Darielsc28/unitypub/docs/oreillette_v1_pcb_cuivre_dessous.png

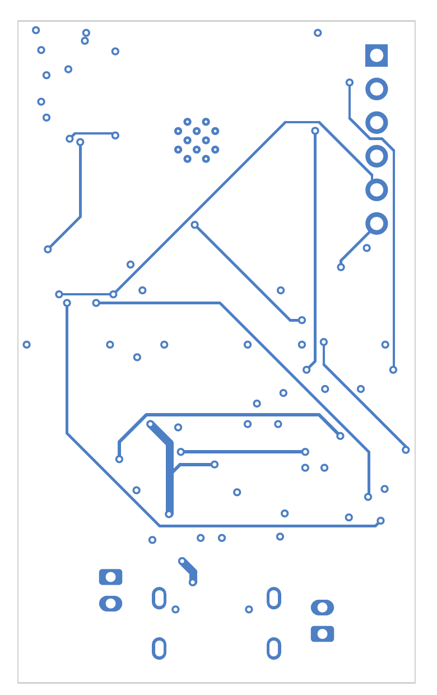
docs/oreillette_v1_pcb_cuivre_dessous.png
