Darielsc28/unitypub/docs/oreillette_v1_pcb_cuivre_dessus.png

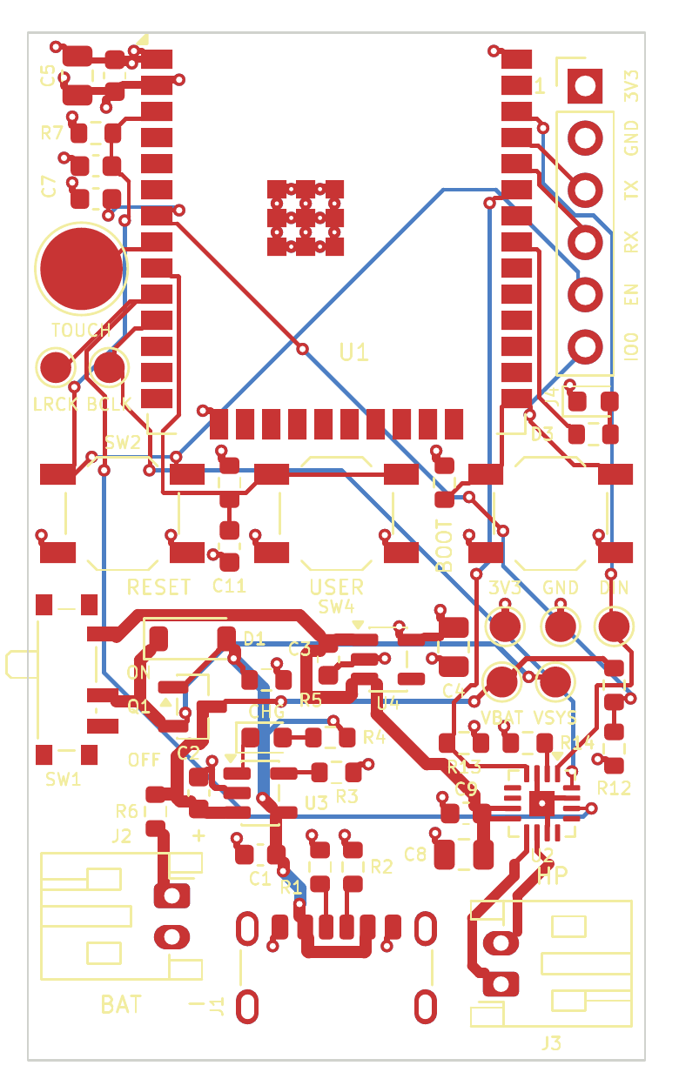
docs/oreillette_v1_pcb_cuivre_dessus.png
