Darielsc28/unitypub/docs/oreillette_v1_pcb_rendu_dessus.png

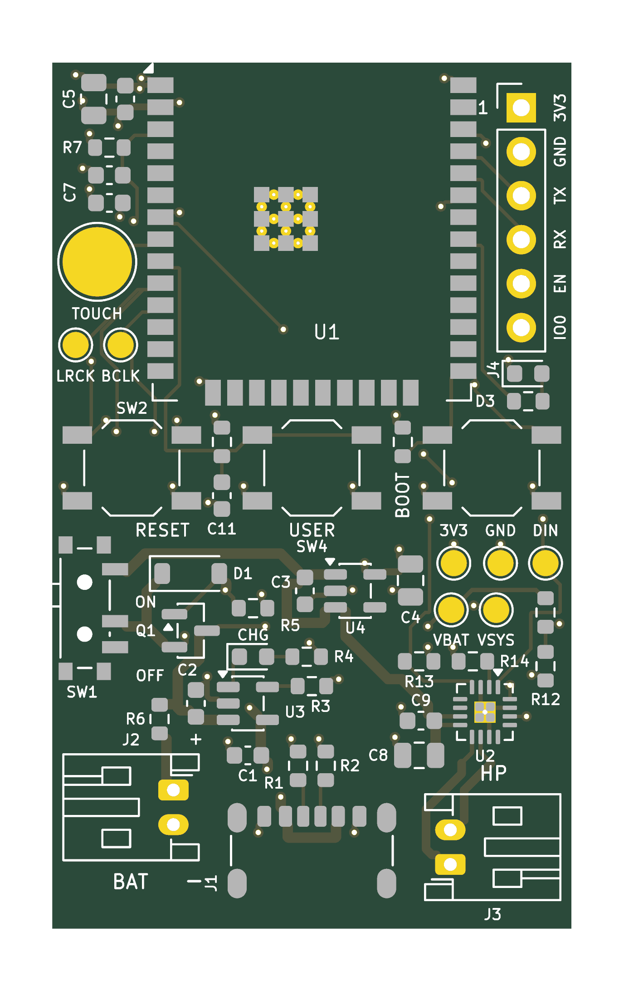
docs/oreillette_v1_pcb_rendu_dessus.png
