Darielsc28/unitypub/docs/oreillette_v1_pcb_couches.pdf

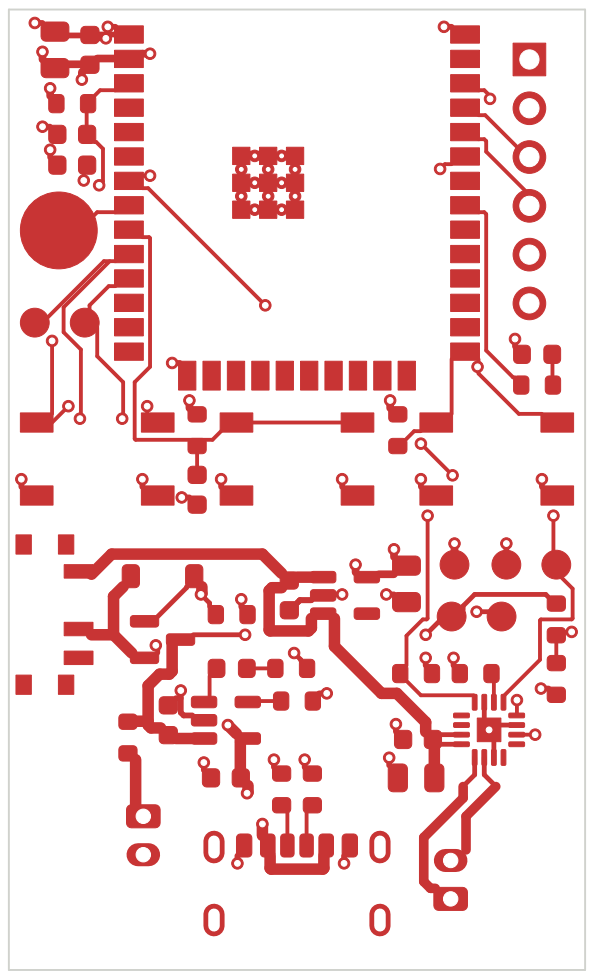
[picture p5: page 1]

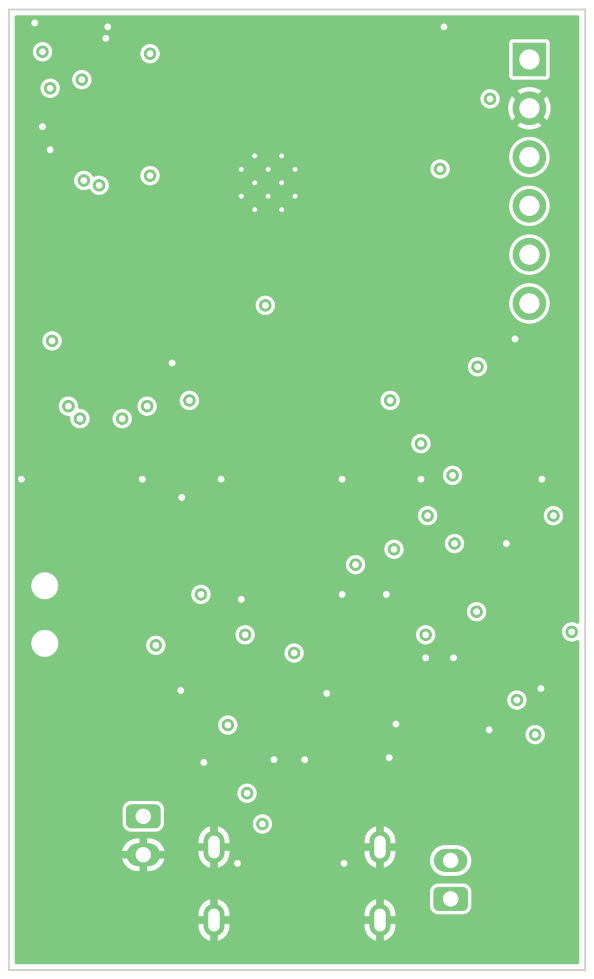
[picture p6: page 2]

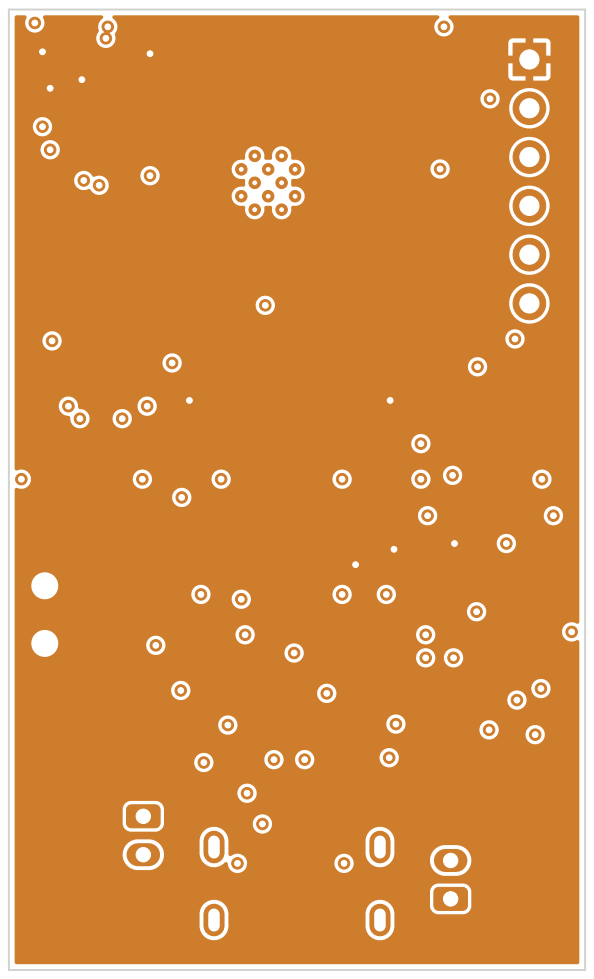
[picture p7: page 3]

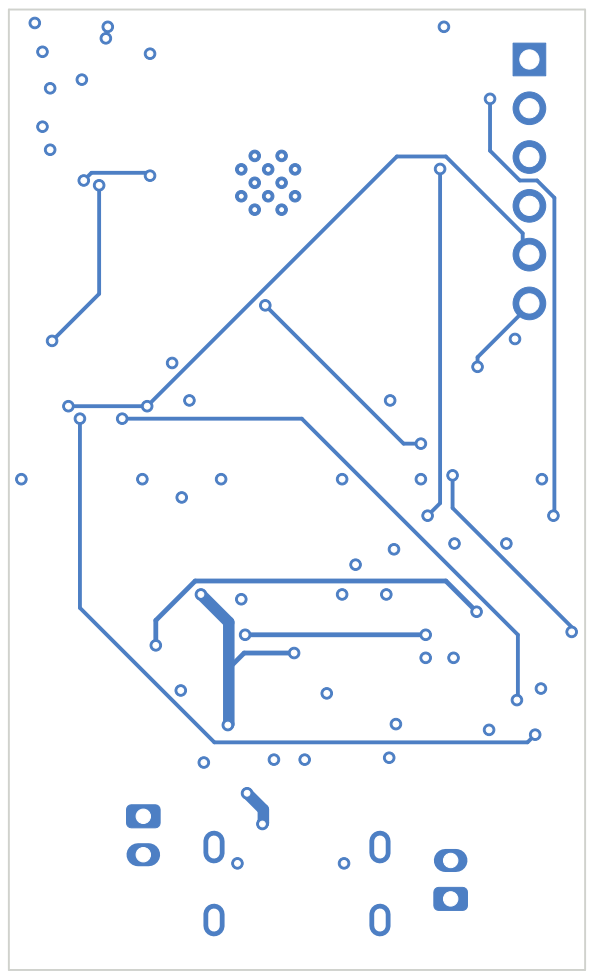
[picture p8: page 4]

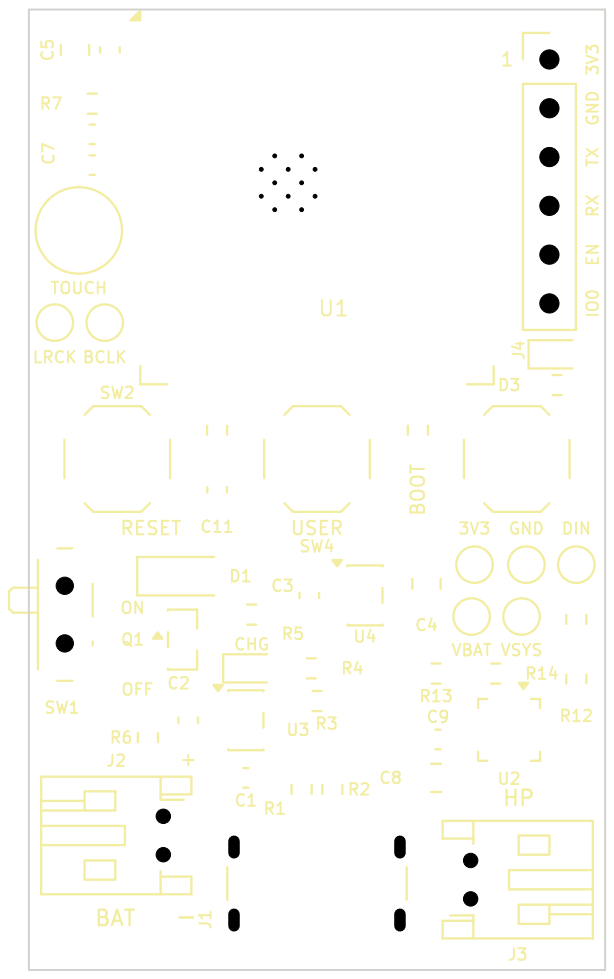
[picture p9: page 5]

3V3 VSYS GND DIN ³V³ GND TX RX EN IO⁰ RESET

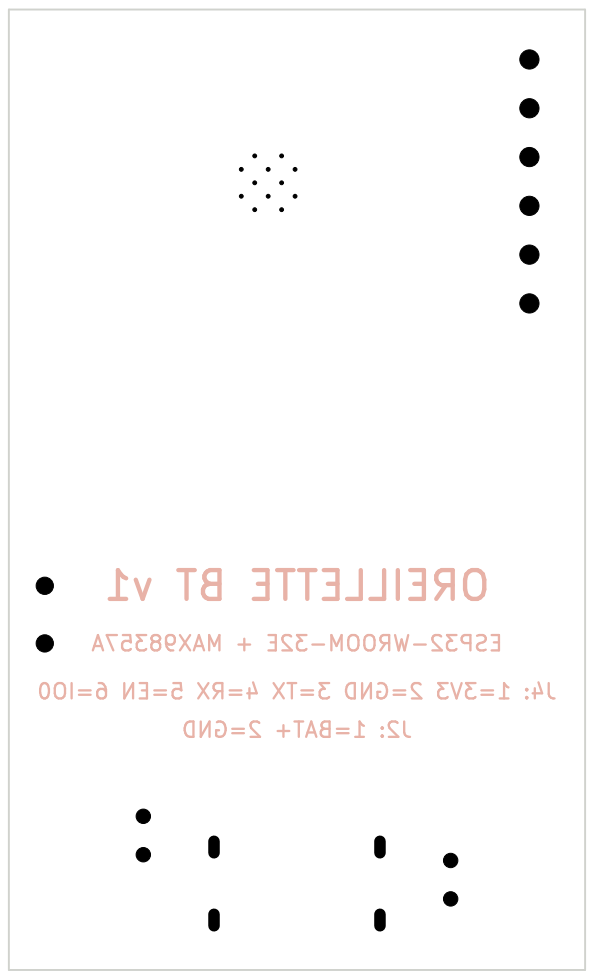
[picture p10: page 6]
MAX98357A + ESP32-WROOM-32E

6=IO0 5=EN 4=RX 3=TX 2=GND 1=3V3 J4: 2=GND 1=BAT+ J2: v1 BT OREILLETTE

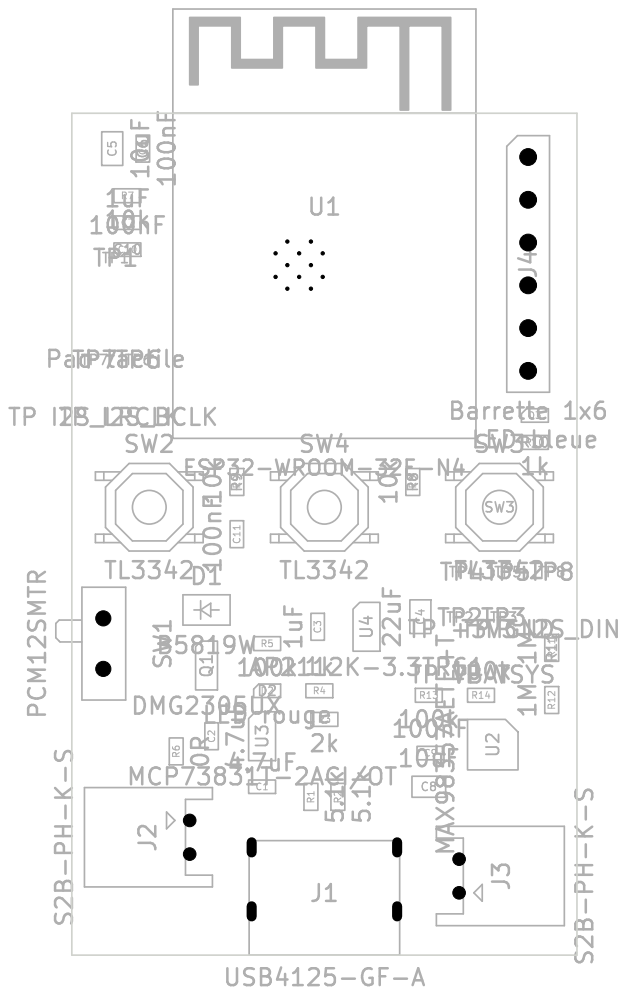
[picture p11: page 7]
