Darielsc28/unitypub/docs/oreillette_v1_schema.pdf

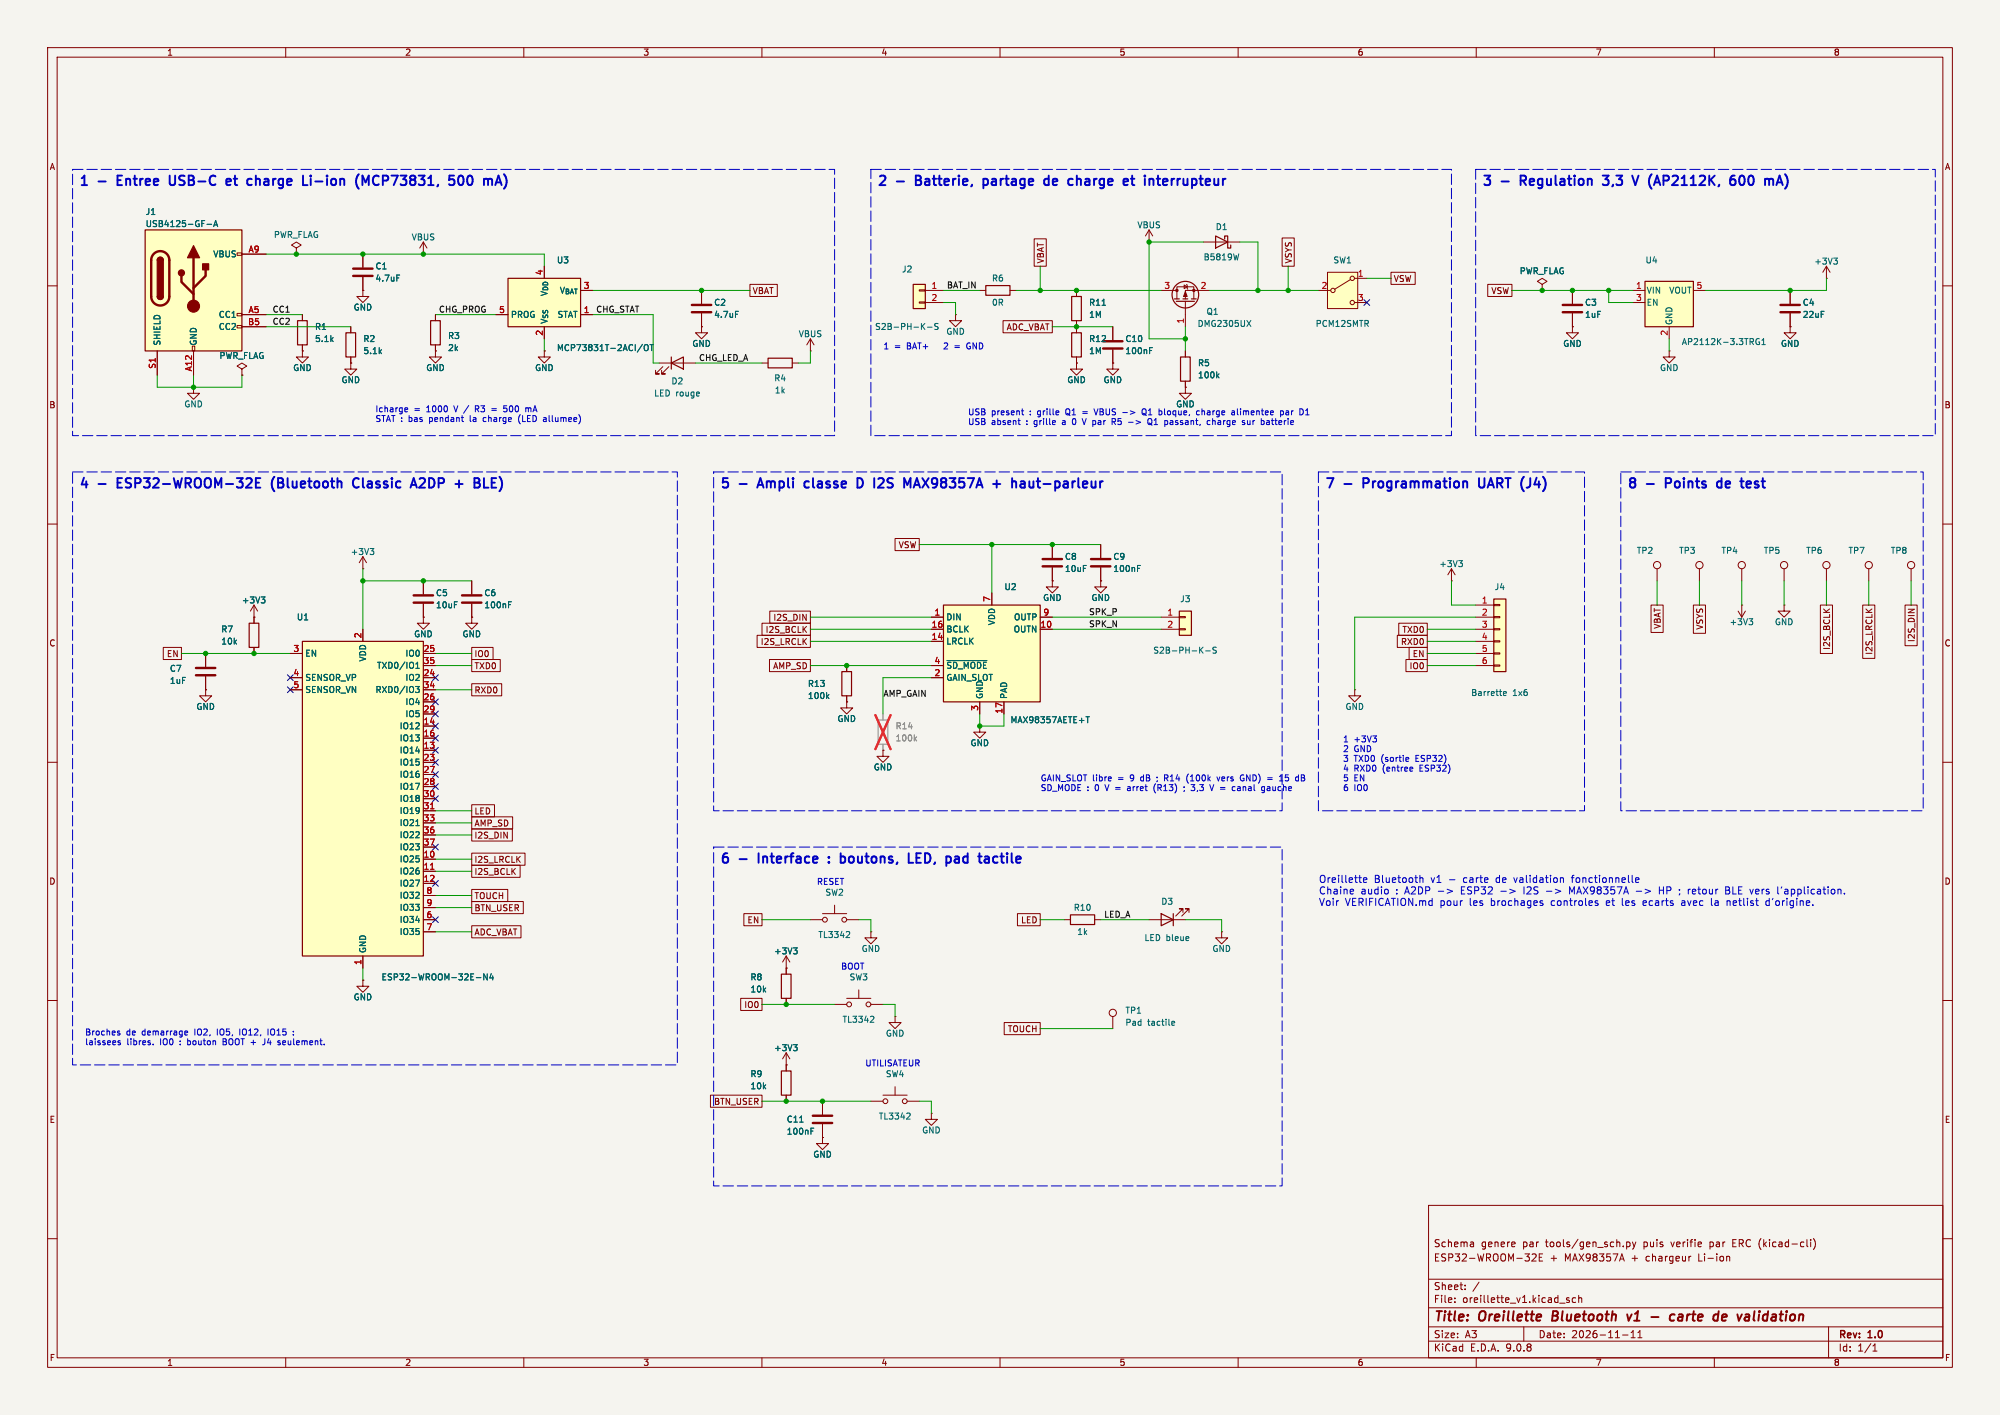
[picture p12: page 1]

SPK_P 2 - Batterie, partage de charge et interrupteur

Icharge = 1000 V / R3 = 500 mA
STAT : bas pendant la charge (LED allumee)

5 - Ampli classe D I2S MAX98357A + haut-parleur BOOT 6 - Interface : boutons, LED, pad tactile

Id: 1/1 Title: Oreillette Bluetooth v1 - carte de validation
