Darielsc28/unitypub/oreillette_v1.kicad_pcb

## KiCad design oreillette_v1.kicad_pcb (2026-11-11)

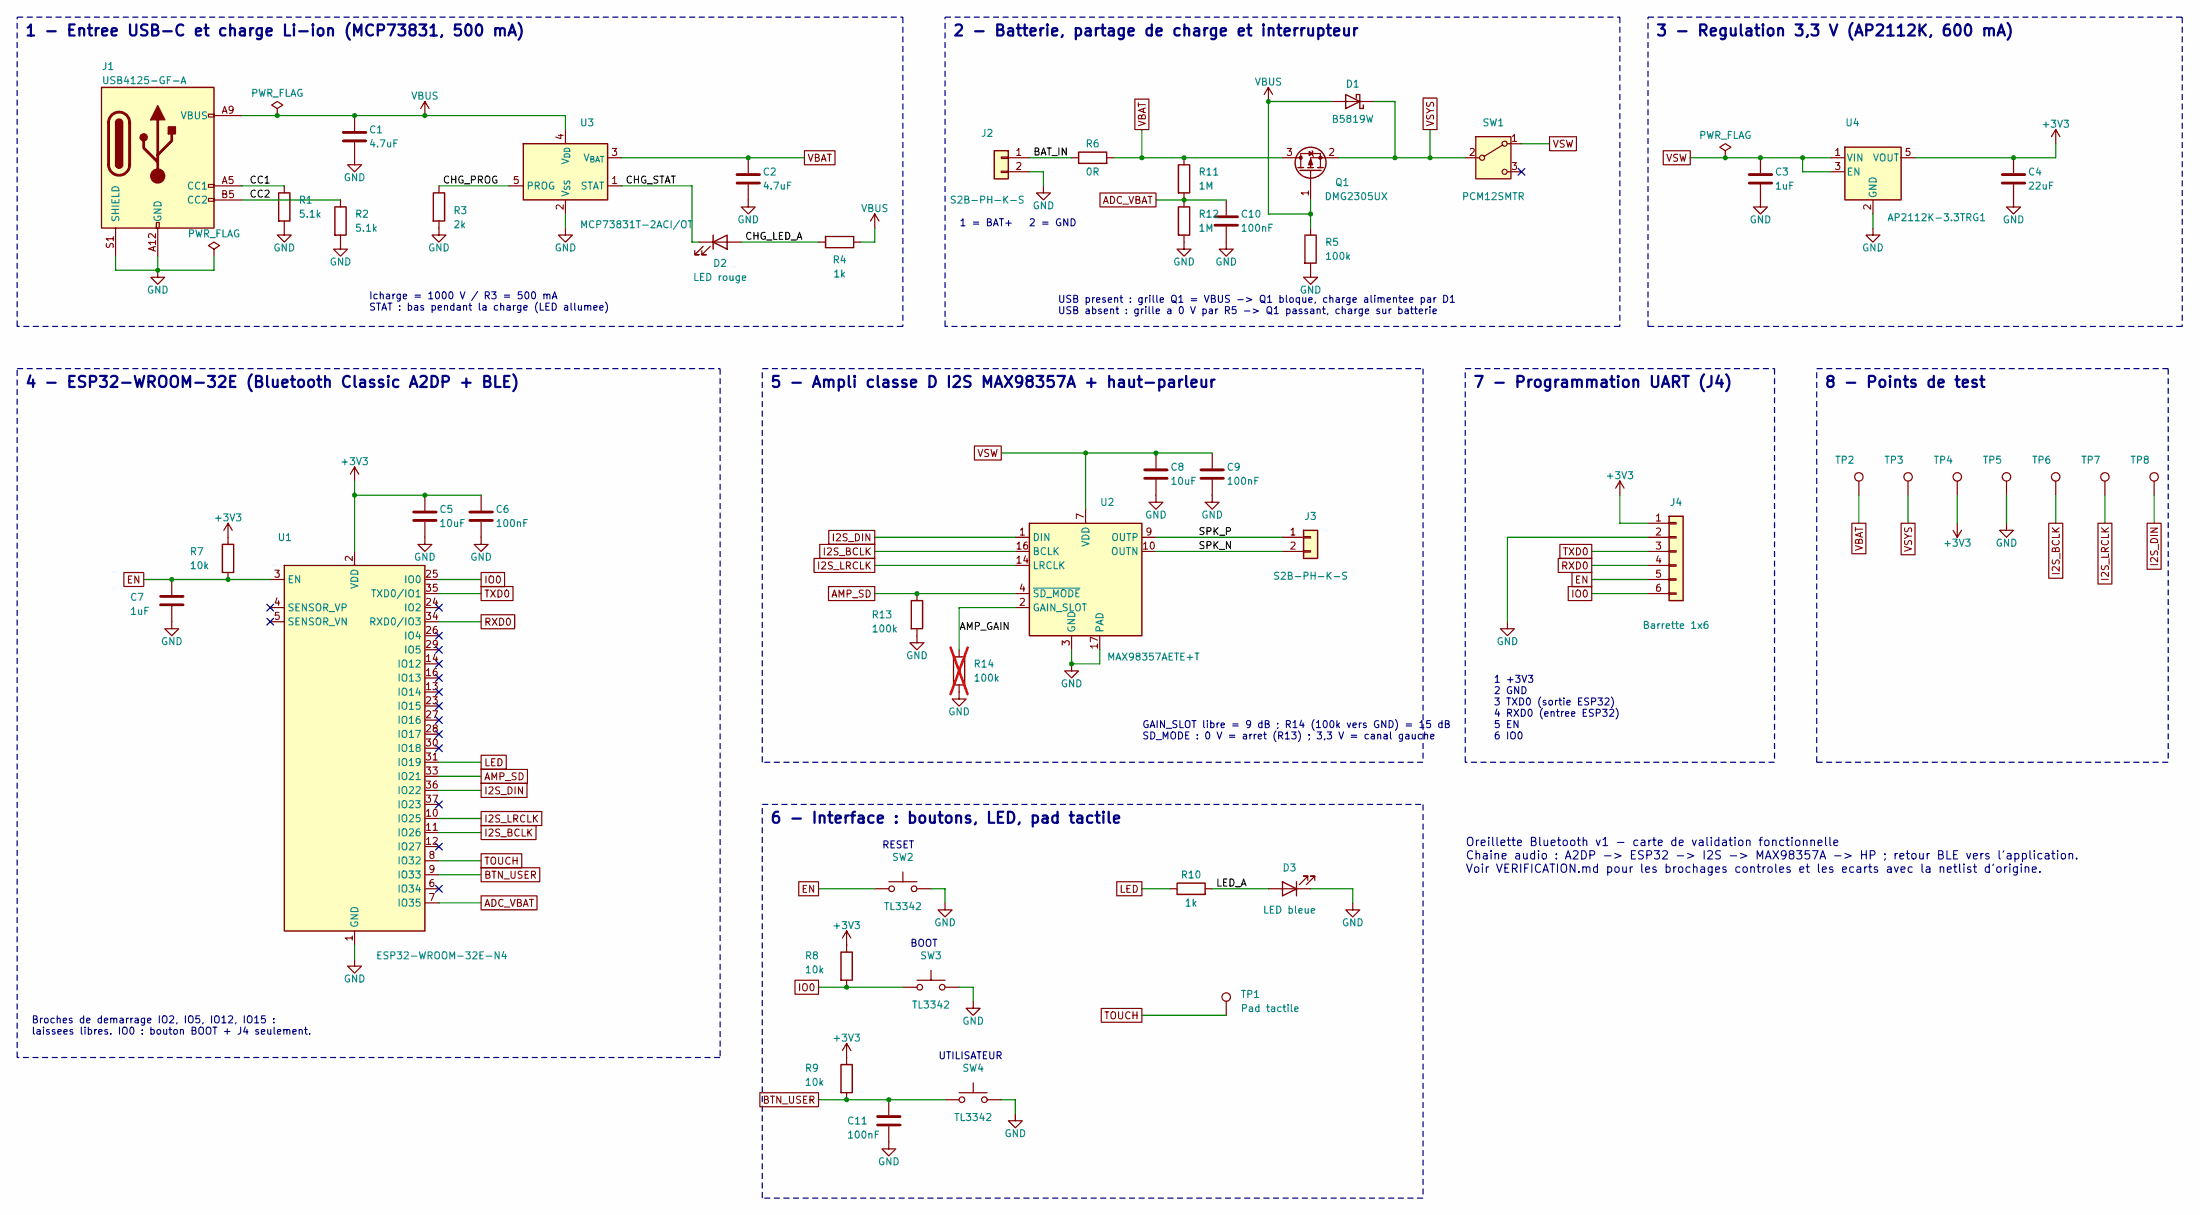
[picture p13: schematic oreillette_v1.kicad_sch, Oreillette Bluetooth v1 - carte de validation]

Parts:
C1, C2: 4.7uF; C_0603_1608Metric
C3, C7: 1uF; C_0603_1608Metric
C4: 22uF; C_0805_2012Metric
C5, C8: 10uF; C_0805_2012Metric
C6, C9, C10, C11: 100nF; C_0603_1608Metric
D1: B5819W; D_SOD-123
D2: LED rouge; LED_0603_1608Metric
D3: LED bleue; LED_0603_1608Metric
J1: USB4125-GF-A; USB_C_Receptacle_GCT_USB4125-xx-x_6P_TopMnt_Horizontal
J2, J3: S2B-PH-K-S; JST_PH_S2B-PH-K_1x02_P2.00mm_Horizontal
J4: Barrette 1x6; PinHeader_1x06_P2.54mm_Vertical
Q1: DMG2305UX; SOT-23
R1, R2: 5.1k; R_0603_1608Metric
R3: 2k; R_0603_1608Metric
R4, R10: 1k; R_0603_1608Metric
R5, R13: 100k; R_0603_1608Metric
R6: 0R; R_0603_1608Metric
R7, R8, R9: 10k; R_0603_1608Metric
R11, R12: 1M; R_0603_1608Metric
R14: 100k; R_0603_1608Metric; not fitted
SW1: PCM12SMTR; SW_SPDT_PCM12
SW2, SW3, SW4: TL3342; SW_SPST_TL3342
TP1: Pad tactile; TestPoint_Pad_D4.0mm
TP2: TP VBAT; TestPoint_Pad_D1.5mm
TP3: TP VSYS; TestPoint_Pad_D1.5mm
TP4: TP +3V3; TestPoint_Pad_D1.5mm
TP5: TP GND; TestPoint_Pad_D1.5mm
TP6: TP I2S_BCLK; TestPoint_Pad_D1.5mm
TP7: TP I2S_LRCLK; TestPoint_Pad_D1.5mm
TP8: TP I2S_DIN; TestPoint_Pad_D1.5mm
U1: ESP32-WROOM-32E-N4; ESP32-WROOM-32E
U2: MAX98357AETE+T; TQFN-16-1EP_3x3mm_P0.5mm_EP1.23x1.23mm
U3: MCP73831T-2ACI/OT; SOT-23-5
U4: AP2112K-3.3TRG1; SOT-23-5

Connections:
+3V3: C4.1, C5.1, C6.1, J4.1, R7.1, R8.1, R9.1, TP4.1, U1.2 (VDD), U4.5 (VOUT)
/AMP_GAIN: R14.1, U2.2 (GAIN_SLOT)
/BAT_IN: J2.1, R6.1
/CC1: J1.A5 (CC1), R1.1
/CC2: J1.B5 (CC2), R2.1
/CHG_LED_A: D2.2 (A), R4.2
/CHG_PROG: R3.1, U3.5 (PROG)
/CHG_STAT: D2.1 (K), U3.1 (STAT)
/LED_A: D3.2 (A), R10.2
/SPK_N: J3.2, U2.10 (OUTN)
/SPK_P: J3.1, U2.9 (OUTP)
ADC_VBAT: C10.1, R11.2, R12.1, U1.7 (IO35)
AMP_SD: R13.1, U1.33 (IO21), U2.4 (~SD_MODE)
BTN_USER: C11.1, R9.2, SW4.1, U1.9 (IO33)
EN: C7.1, J4.5, R7.2, SW2.1, U1.3 (EN)
GND: C1.2, C2.2, C3.2, C4.2, C5.2, C6.2, C7.2, C8.2, C9.2, C10.2, C11.2, D3.1 (K), J1.A12 (GND), J1.B12 (GND), J1.S1 (SHIELD), J2.2, J4.2, R1.2, R2.2, R3.2, R5.2, R12.2, R13.2, R14.2, SW2.2, SW3.2, SW4.2, TP5.1, U1.1 (GND), U1.15 (GND), U1.38 (GND), U1.39 (GND), U2.3 (GND), U2.11 (GND), U2.15 (GND), U2.17 (PAD), U3.2 (V_{SS}), U4.2 (GND)
I2S_BCLK: TP6.1, U1.11 (IO26), U2.16 (BCLK)
I2S_DIN: TP8.1, U1.36 (IO22), U2.1 (DIN)
I2S_LRCLK: TP7.1, U1.10 (IO25), U2.14 (LRCLK)
IO0: J4.6, R8.2, SW3.1, U1.25 (IO0)
LED: R10.1, U1.31 (IO19)
RXD0: J4.4, U1.34 (RXD0/IO3)
TOUCH: TP1.1, U1.8 (IO32)
TXD0: J4.3, U1.35 (TXD0/IO1)
VBAT: C2.1, Q1.3 (D), R6.2, R11.1, TP2.1, U3.3 (V_{BAT})
VBUS: C1.1, D1.2 (A), J1.A9 (VBUS), J1.B9 (VBUS), Q1.1 (G), R4.1, R5.1, U3.4 (V_{DD})
VSW: C3.1, C8.1, C9.1, SW1.1 (A), U2.7 (VDD), U2.8 (VDD), U4.1 (VIN), U4.3 (EN)
VSYS: D1.1 (K), Q1.2 (S), SW1.2 (B), TP3.1

Notes on the sheet:
1 - Entree USB-C et charge Li-ion (MCP73831, 500 mA)
Icharge = 1000 V / R3 = 500 mA STAT : bas pendant la charge (LED allumee)
2 - Batterie, partage de charge et interrupteur
1 = BAT+ 2 = GND
USB present : grille Q1 = VBUS -> Q1 bloque, charge alimentee par D1 USB absent : grille a 0 V par R5 -> Q1 passant, charge sur batterie
3 - Regulation 3,3 V (AP2112K, 600 mA)
4 - ESP32-WROOM-32E (Bluetooth Classic A2DP + BLE)
Broches de demarrage IO2, IO5, IO12, IO15 : laissees libres. IO0 : bouton BOOT + J4 seulement.
5 - Ampli classe D I2S MAX98357A + haut-parleur
GAIN_SLOT libre = 9 dB ; R14 (100k vers GND) = 15 dB SD_MODE : 0 V = arret (R13) ; 3,3 V = canal gauche
6 - Interface : boutons, LED, pad tactile
RESET
BOOT
UTILISATEUR
7 - Programmation UART (J4)
1 +3V3 2 GND 3 TXD0 (sortie ESP32) 4 RXD0 (entree ESP32) 5 EN 6 IO0
8 - Points de test
Oreillette Bluetooth v1 - carte de validation fonctionnelle Chaine audio : A2DP -> ESP32 -> I2S -> MAX98357A -> HP ; retour BLE vers l'application. Voir VERIFICATION.md pour les brochages controles et les ecarts avec la netlist d'origine.

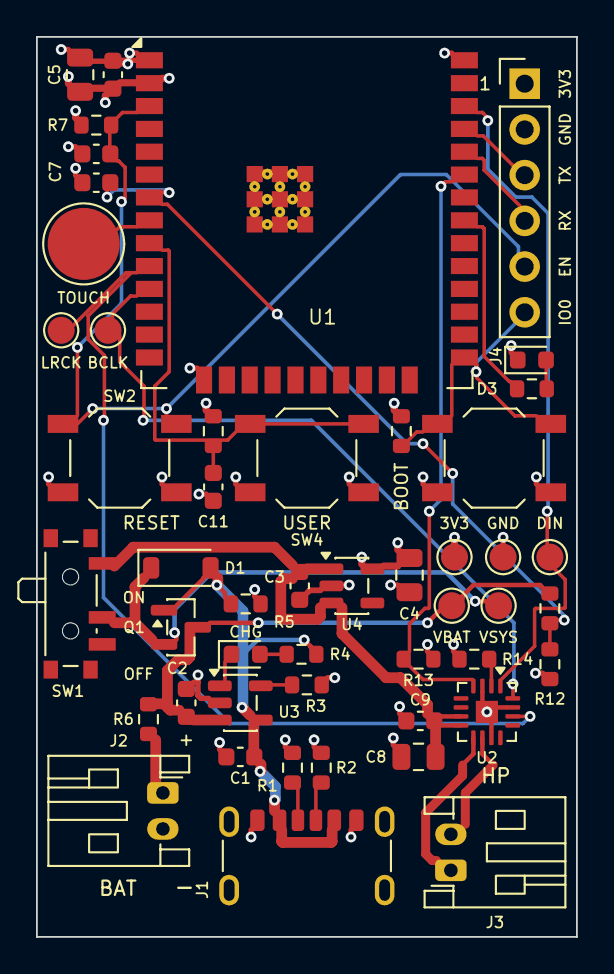
[picture p14: board oreillette_v1.kicad_pcb from above]

Board: 4 copper layers, 30.0 x 50.0 mm, 49 parts (0 on the bottom side), 28 nets.
