Darielsc28/unitypub/(commit log)

2026-11-11 Schéma KiCad 9 de l'oreillette v1 (projet, schéma par blocs, PDF)
    - oreillette_v1.kicad_pro / .kicad_sch au format KiCad 9.0.8
    - schéma organisé en 8 blocs, généré par tools/gen_sch.py à partir des
    symboles des bibliothèques KiCad installées
    - connectivité comparée à la netlist d'origine (tools/compare_netlist.py)
    - ERC kicad-cli : 0 erreur, 1 avertissement (pad thermique U2)
    - export PDF dans docs/
    Claude-Session: https://claude.ai/code/session_01DUTzdUrUGzxFsvCahxm2Kd
    [oreillette_v1.kicad_sch]
2026-11-11 Placement du PCB 4 couches 30 x 50 mm (contour, empreintes, plans, sérigraphie)
    - oreillette_v1.kicad_pcb : 49 empreintes placées, non routé
    - empilage F.Cu signal / In1.Cu GND / In2.Cu +3V3 / B.Cu signal
    - module ESP32 au bord haut, antenne en débord (aucun cuivre dessous)
    - ampli et connecteur haut-parleur dans le coin opposé à l'antenne
    - découplages collés aux broches d'alimentation
    - tools/gen_pcb.py + tools/silk.py : génération reproductible du placement
    - parité schéma/PCB : 0 écart ; cours : 0 chevauchement
    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
    [oreillette_v1.kicad_pcb]
2026-11-11 Routage du PCB (F.Cu/B.Cu, vias vers les plans GND et +3V3)
    - 274 segments, 69 vias traversants 0,6/0,3 mm, aucune connexion manquante
    - VBUS/VBAT/VSYS/VSW/BAT_IN en 0,6 mm ; haut-parleur en 0,5 mm ; signaux 0,2 mm
    - GND et +3V3 distribués par les plans internes (un via par pastille CMS)
    - tools/route.py : routeur sur grille 0,05 mm utilisé pour calculer les pistes
    - tools/check_pcb.py : mesures de contrôle (largeurs, vias, distances)
    - DRC kicad-cli : 0 erreur, parité schéma/PCB sans écart
    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
    [oreillette_v1.kicad_pcb]
2026-11-11 Vérification : VERIFICATION.md, rapports ERC/DRC et exports de relecture
    - VERIFICATION.md : brochages contrôlés sur les fiches fabricants, écarts
    avec la netlist d'origine, résultats ERC/DRC, points non vérifiés
    - docs/erc.rpt (0 erreur, 1 avertissement expliqué)
    - docs/drc.rpt (0 erreur, 0 non connecté, 2 avertissements expliqués)
    - PDF du schéma, rendus et tracés des couches du PCB
    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
